omega9380/SWTPC6809/Documentation/MF-68 Disc System/MF_68_Wiring.jpg

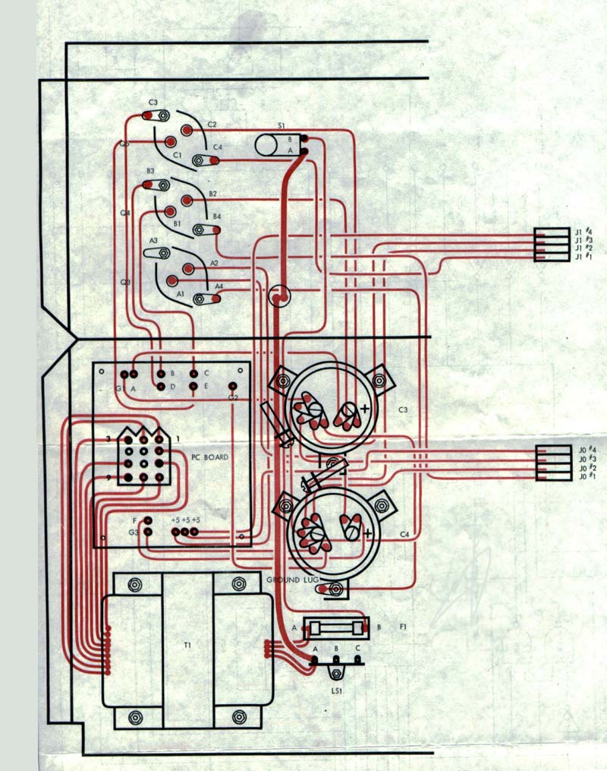
Documentation/MF-68 Disc System/MF_68_Wiring.jpg
