omega9380/SWTPC6809/Documentation/SouthWest Technical Products Corp. 69K Computer/69K_Transformer.jpg

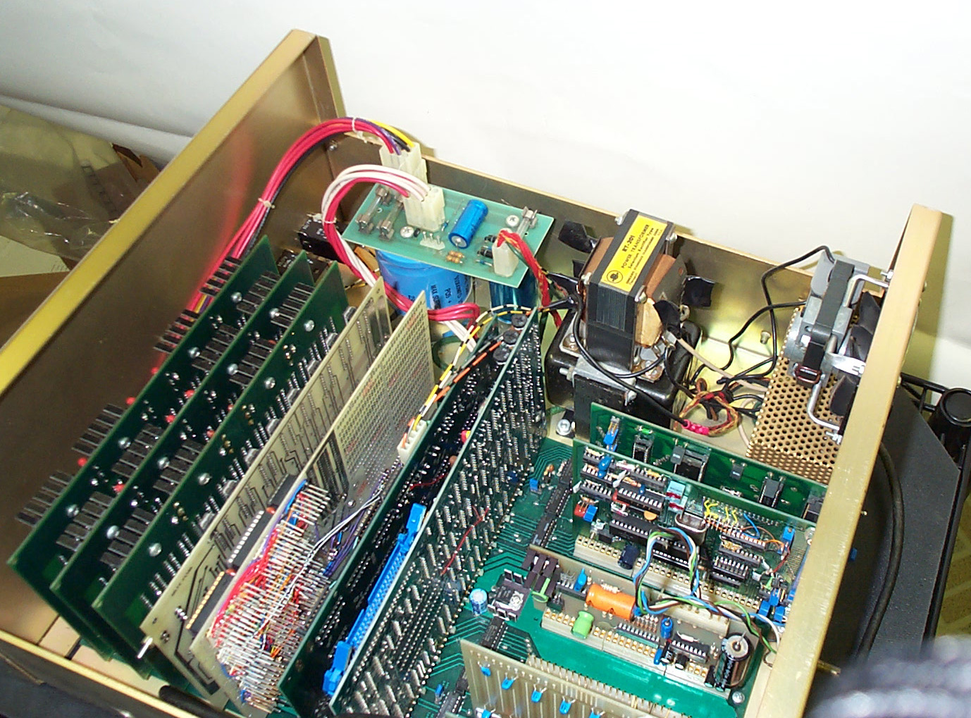
Documentation/SouthWest Technical Products Corp. 69K Computer/69K_Transformer.jpg
