omega9380/SWTPC6809/README.md

# SWTPC6908
My attempt at recreating the SWTPC 6809 Computer System from 1979!

Special thanks to Michael Holley who set up the awesome [SWTPC Collection Home Page](https://deramp.com/swtpc.com) where I found every document I needed for this project!
