omega9380/SWTPC6809/SWTPC6809/README.md

# SWTPC6809 KiCAD Project Directory

Contains the files for my SWTPC 6809 KiCAD project
