omega9380/SWTPC6809/Documentation/README.md

# SWTPC 6809 Computer System

SWTPC 69/K Computer with a MP-09 Processor Board, a MP-8M 8K Static RAM, a MP-B3 Mother Board, and a MP-S2 Serial Interface

Copyright 2000-2012, Michael Holley
