omega9380/SWTPC6809/Documentation/DC-4 Disk Controller Board/README.md

# DC-4 Disk Controller Board

The SWTPC minifloppy disk unit is a dual drive, double sided, five-inch disk unit. Double density operation is also available when using the DC-4 disk controller board. The disk unit was designed specifically for the SWTPC 6809 computer. Although the disk unit was completely assembled and tested at the factory, minor reprogramming of the circuit board may be necessary to operate with your particular computer system.

Introduced by Southwest Technical Products Corporation in 19??. The assembled board cost $200.

Copyright 2000-2012, Michael Holley
