omega9380/SWTPC6809/Documentation/MP-ID Interface Driver Board/MP_ID_Schematic.pdf

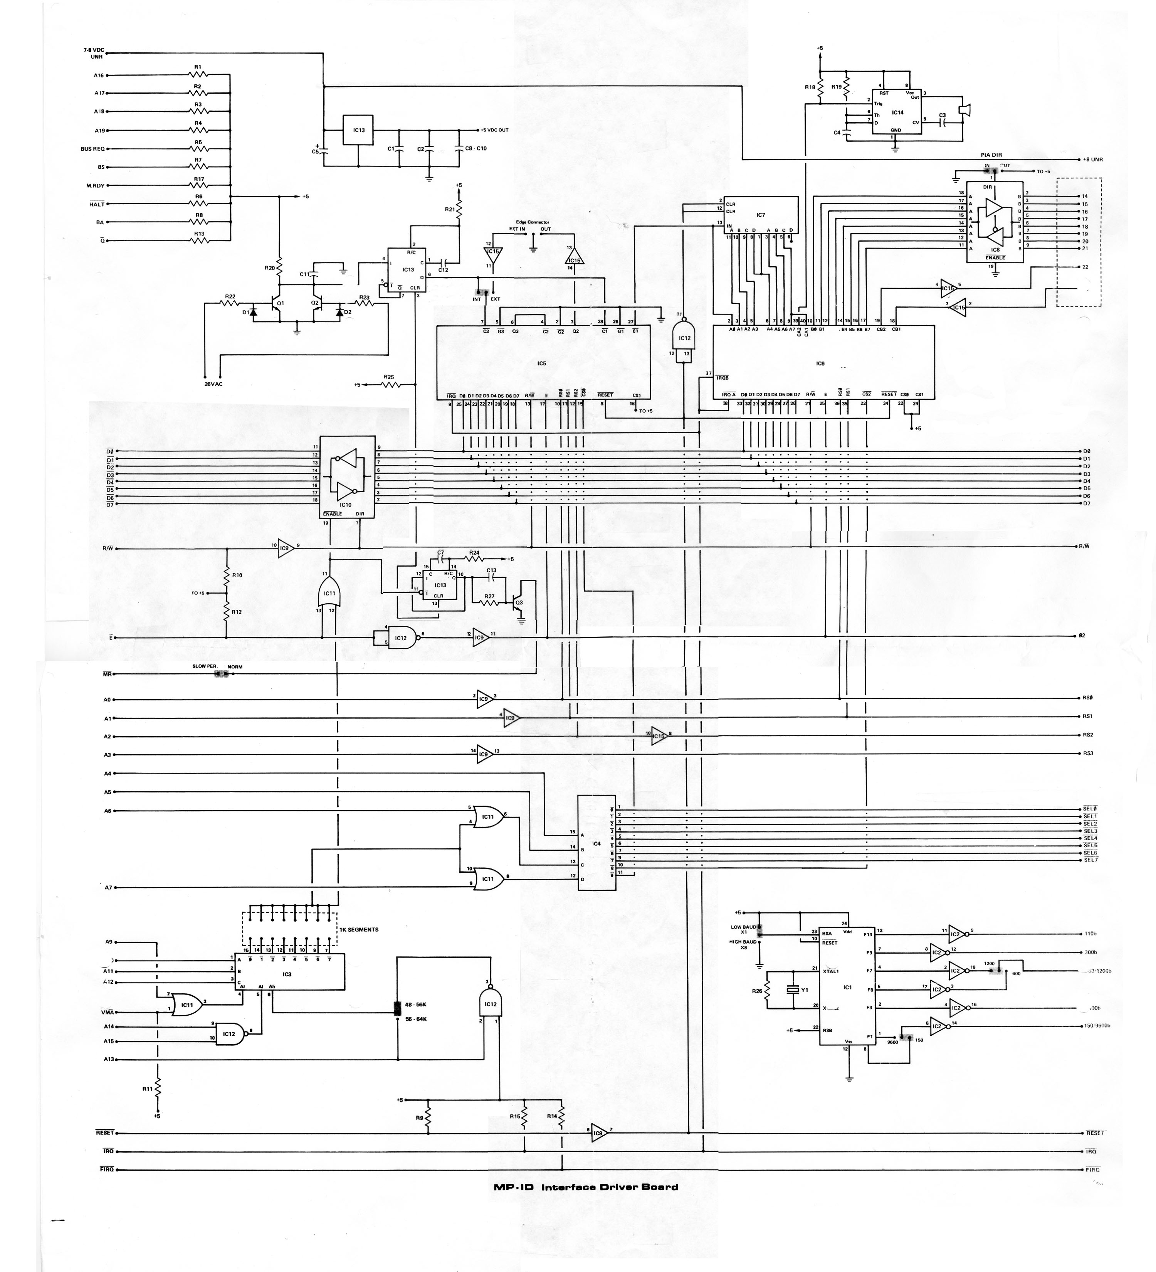
[picture p4: page 1]
