omega9380/SWTPC6809/Documentation/MP-ID Interface Driver Board/MP_ID_RedBlue.pdf

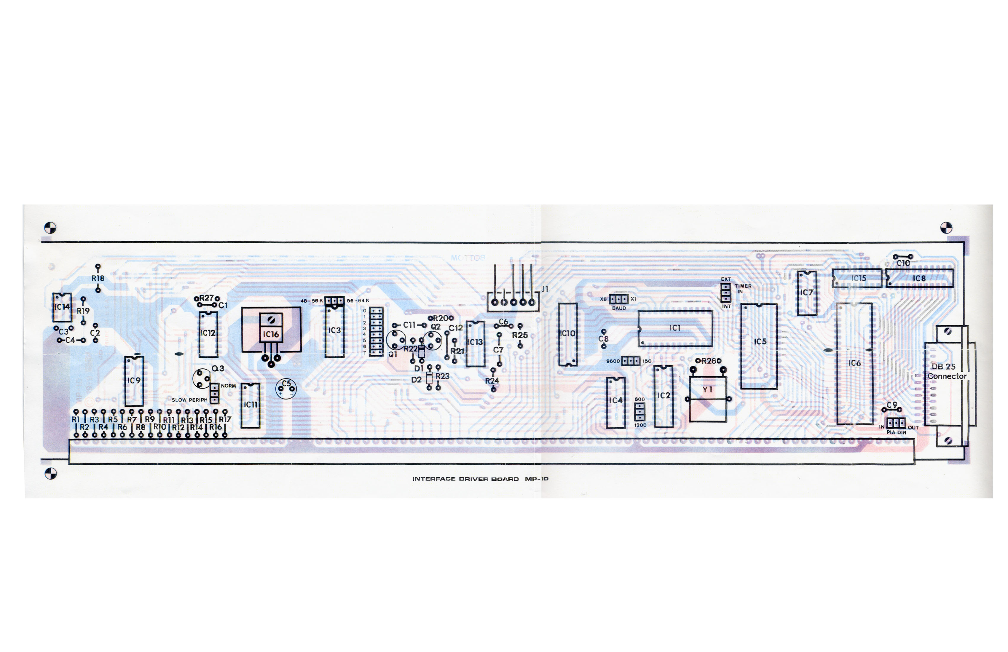
[picture p5: page 1]
