omega9380/SWTPC6809/Documentation/DC-4 Disk Controller Board/DC4_Schematic200.jpg

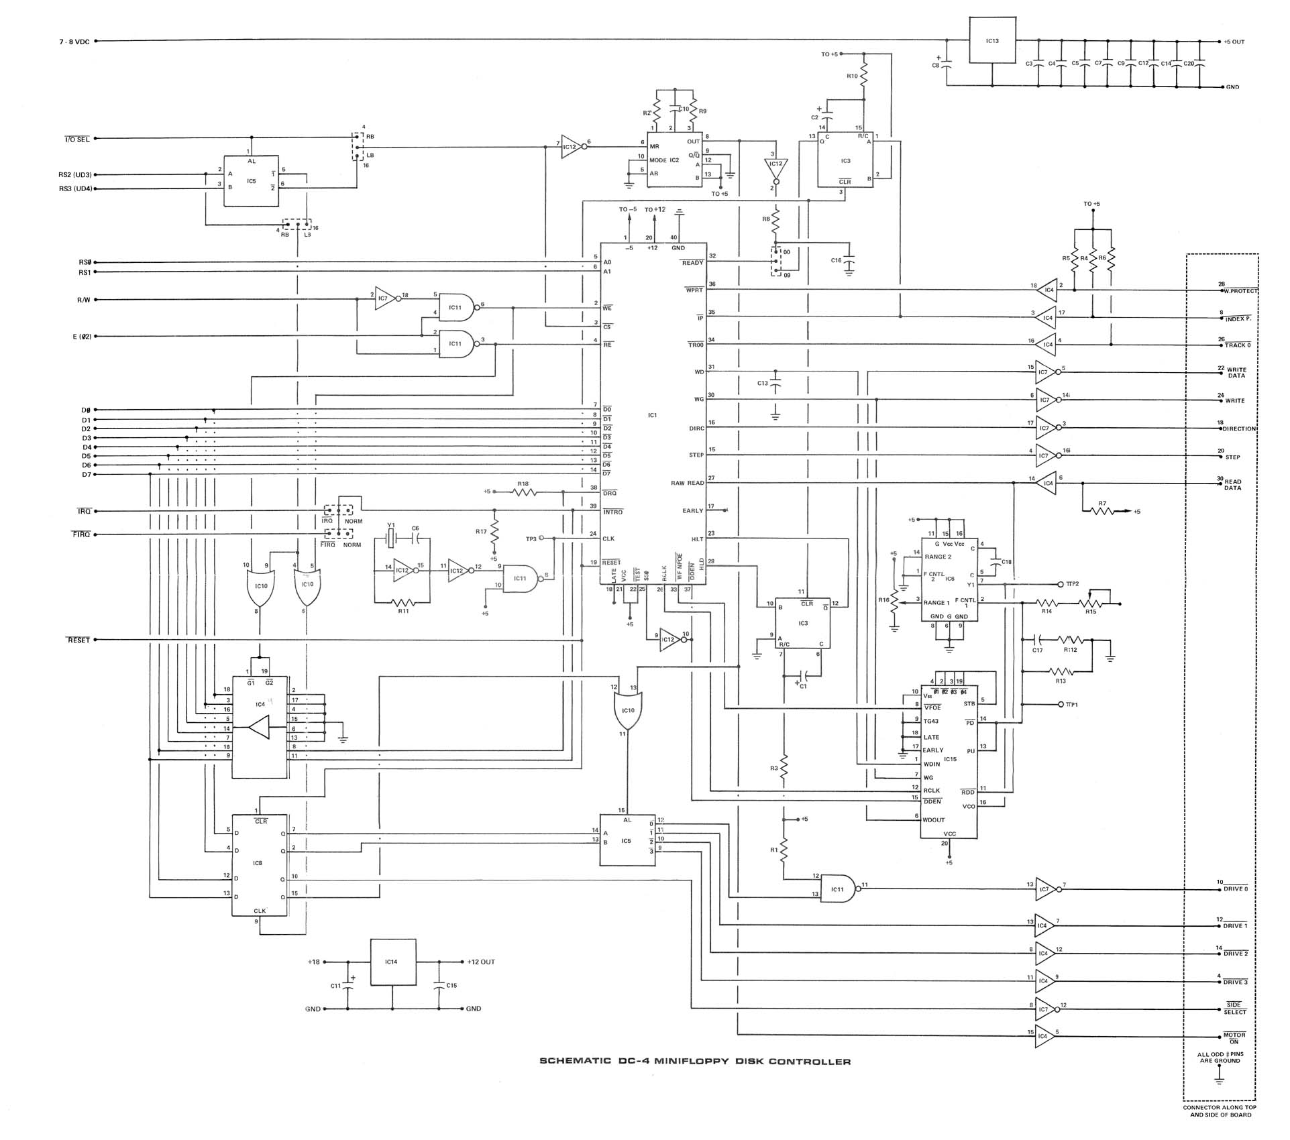
Documentation/DC-4 Disk Controller Board/DC4_Schematic200.jpg
