omega9380/SWTPC6809/Documentation/Digital Research Tanner 64K SS-50C Memory Board/64K_RAM_Photo640.jpg

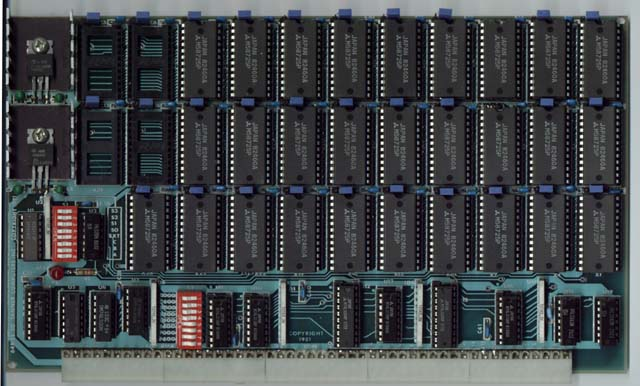
Documentation/Digital Research Tanner 64K SS-50C Memory Board/64K_RAM_Photo640.jpg
