omega9380/SWTPC6809/Documentation/MF-68 Disc System/DC1_Photo640.jpg

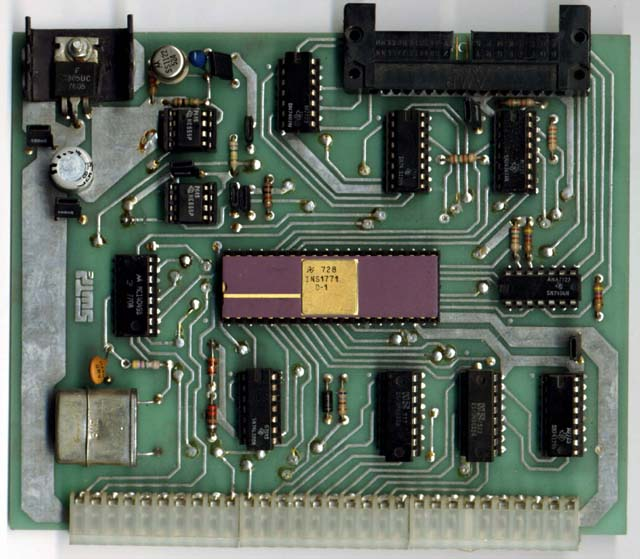
Documentation/MF-68 Disc System/DC1_Photo640.jpg
