omega9380/SWTPC6809/Documentation/MP-8M Memory Board/MP_8M_Photo640.jpg

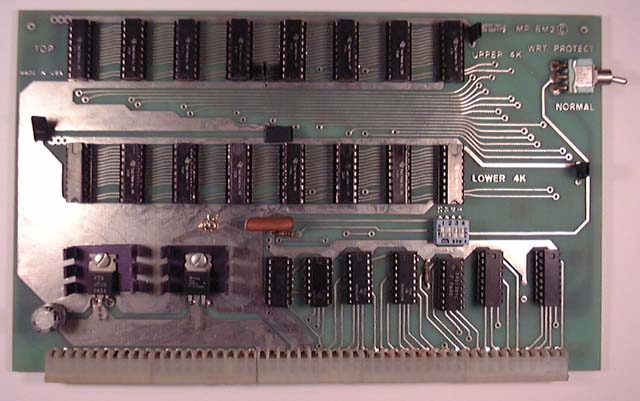
Documentation/MP-8M Memory Board/MP_8M_Photo640.jpg
