omega9380/SWTPC6809/Documentation/MP-09 Processor Board/MP_09_Photo640.jpg

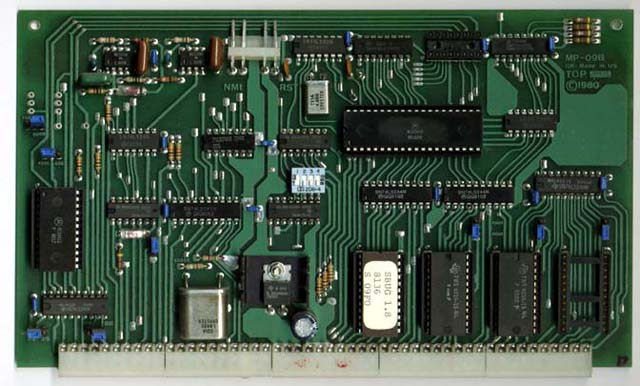
Documentation/MP-09 Processor Board/MP_09_Photo640.jpg
