omega9380/SWTPC6809/Documentation/MP-09 Processor Board/MP_ID_Board.jpg

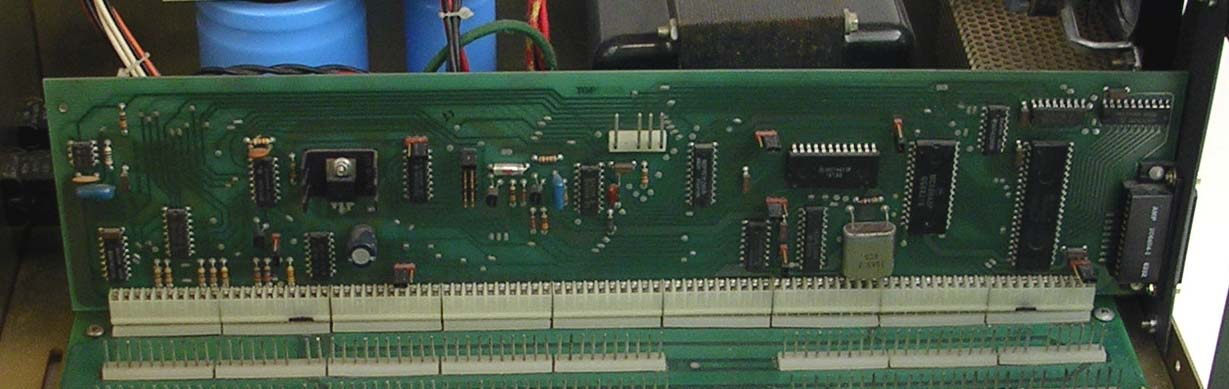
Documentation/MP-09 Processor Board/MP_ID_Board.jpg
