omega9380/SWTPC6809/Documentation/MP-ID Interface Driver Board/MP_ID_Photo.jpg

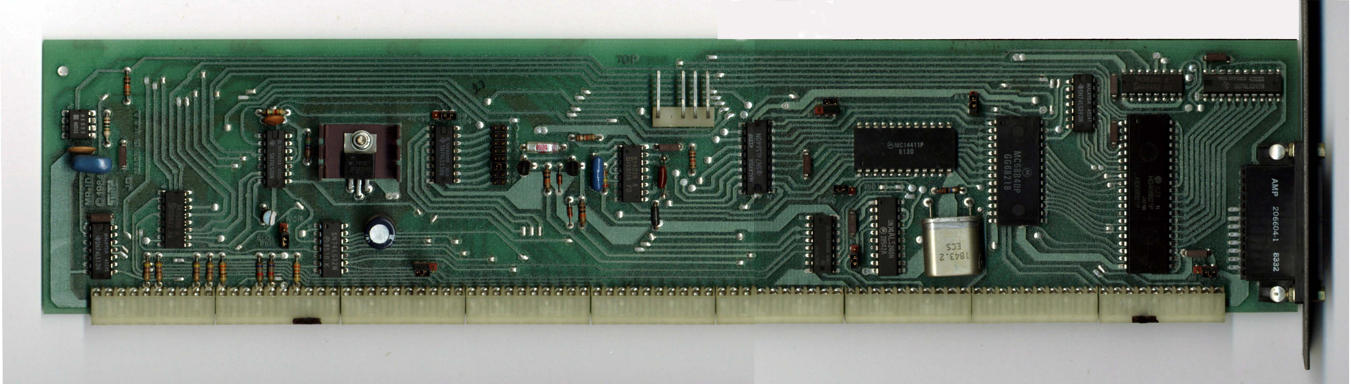
Documentation/MP-ID Interface Driver Board/MP_ID_Photo.jpg
