omega9380/SWTPC6809/Documentation/MP-L2 Parallel Interface/MP_L2_Photo640.jpg

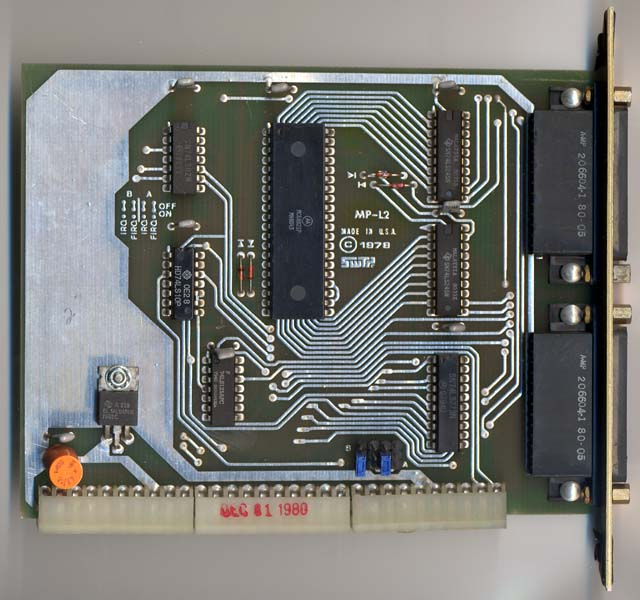
Documentation/MP-L2 Parallel Interface/MP_L2_Photo640.jpg
