omega9380/SWTPC6809/Documentation/MP-S2 Serial Interface/MP_S2_Photo640.jpg

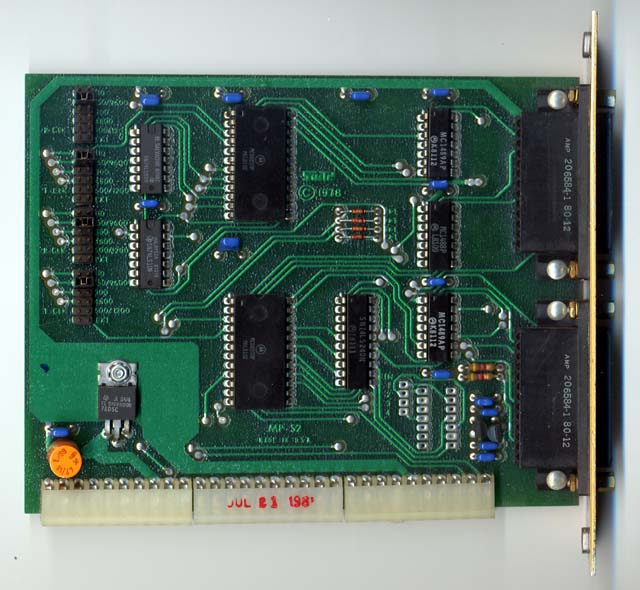
Documentation/MP-S2 Serial Interface/MP_S2_Photo640.jpg
