omega9380/SWTPC6809/Documentation/SouthWest Technical Products Corp. 69K Computer/AM9512_Board.jpg

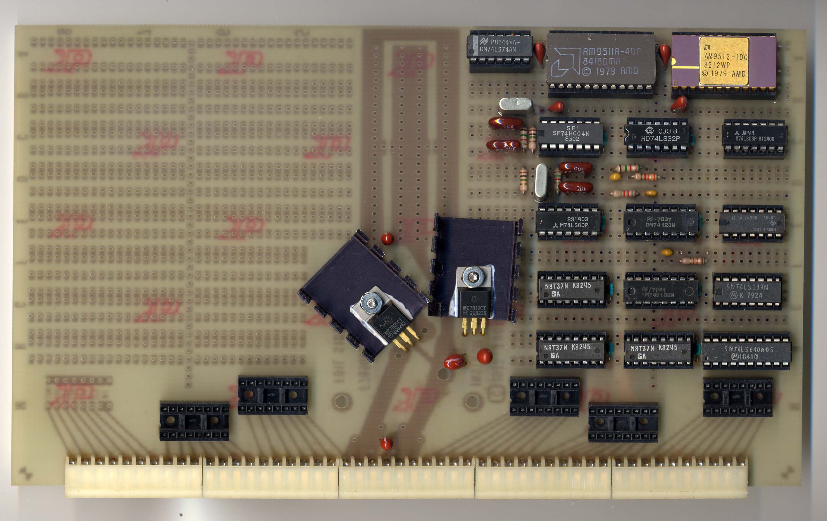
Documentation/SouthWest Technical Products Corp. 69K Computer/AM9512_Board.jpg
