omega9380/SWTPC6809/Documentation/SouthWest Technical Products Corp. 69K Computer/DC4_Front.jpg

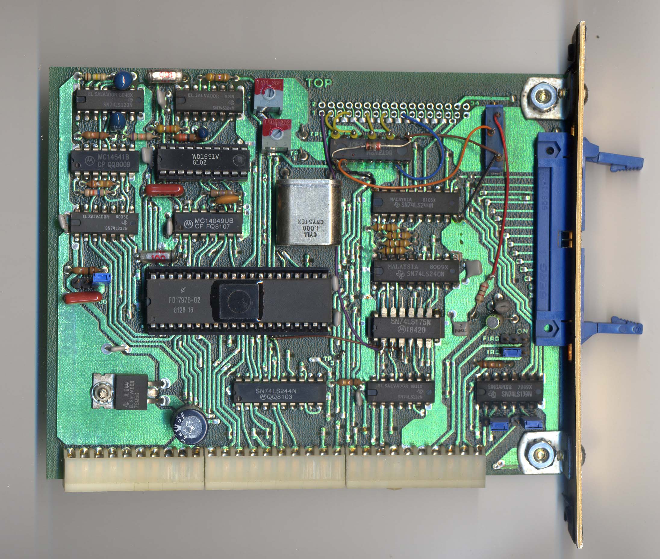
Documentation/SouthWest Technical Products Corp. 69K Computer/DC4_Front.jpg
