omega9380/SWTPC6809/Documentation/SouthWest Technical Products Corp. 69K Computer/MPS2_Front.jpg

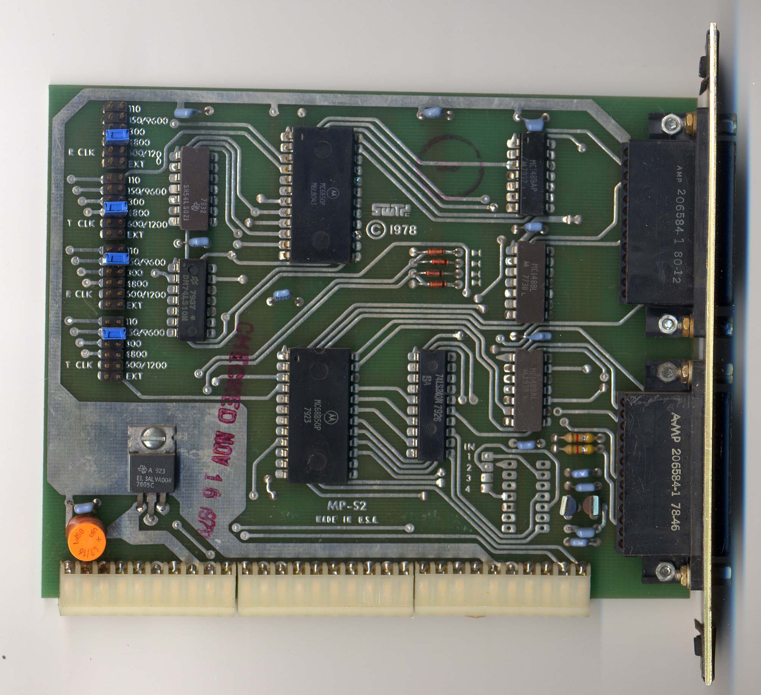
Documentation/SouthWest Technical Products Corp. 69K Computer/MPS2_Front.jpg
