omega9380/SWTPC6809/Documentation/SWTPC S09 Computer System/S09_DC5.jpg

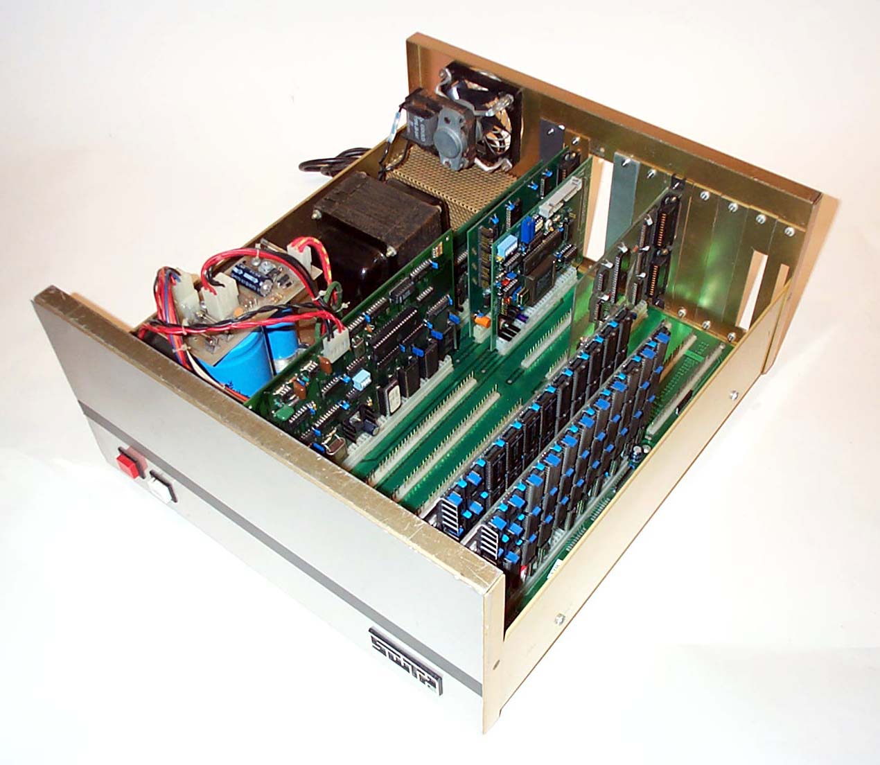
Documentation/SWTPC S09 Computer System/S09_DC5.jpg
